otavioaugusto-dev/AquaRescue-ROV/PROJECT_ARCHITECTURE.md

# AquaRescue ROV
## Project Architecture Specification

---

**Project Name:** "Embarcação Robótica de Reconhecimento e Localização de Vítimas de Afogamento"

**Repository:**  
https://github.com/otavioaugusto-dev/AquaRescue-ROV

**Development Period:**  
2023 – 2025

**Institution:**  
Robotics Club – Colégio Militar do Corpo de Bombeiros do Ceará (CMCB)

**Primary Contributor:**  
Otávio Augusto

**Document Version:**  
v1.0

**Document Status:**  
In Development

---

# Table of Contents

1. Project Overview
2. Problem Statement
3. Project Objectives
4. Stakeholders
5. Engineering Requirements
6. System Overview 
7. Mechanical Architecture 
8. Electrical Architecture 
9. Embedded System 
10. Computer Vision System 
11. Communication Architecture 
12. Power Distribution 
13. Operating Modes 
14. Validation and Field Testing 
15. Engineering Trade-offs
16. Project Limitations
17. Awards and Recognition
18. Lessons Learned
19. Future Improvements
Appendix A — Acronyms
Appendix B — Revision History

---

# 1. Project Overview

## Abstract

AquaRescue is a low-cost robotic surface vehicle developed to assist search and rescue operations involving drowning victims. The project combines embedded systems, computer vision, wireless communication, naval engineering concepts, and artificial intelligence to provide firefighters with a technological support platform capable of improving operational safety and increasing search efficiency.

The platform was conceived through a user-centered engineering approach, beginning with interviews conducted with military firefighters, rescue divers, and professionals experienced in aquatic rescue operations. Their operational requirements guided the project's conception and technical decisions throughout its development.

Unlike conventional remotely operated platforms focused exclusively on teleoperation, AquaRescue integrates autonomous assistance features through computer vision techniques capable of identifying people in real time from underwater video streams. The system also incorporates modular mechanical construction, reusable materials, wireless communication, embedded propulsion control, and a portable operator station.

Throughout its development, AquaRescue evolved from an initial concept into a validated research prototype tested in controlled aquatic environments and presented at national scientific competitions. The project demonstrates how affordable engineering solutions can contribute to public safety while simultaneously serving as an educational platform for multidisciplinary engineering research.

---

# 2. Problem Statement

According to the World Health Organization (WHO), drowning causes more than 236,000 deaths every year worldwide, remaining one of the leading causes of accidental mortality.

Search operations performed by rescue teams are frequently characterized by long operational periods, limited underwater visibility, significant physical effort, and considerable risks to rescue divers. These factors increase operational costs while exposing professionals to hazardous environments.

During the project's conception phase, the development team interviewed firefighters, rescue divers, and military personnel from the Ceará Military Fire Department (CBMCE). These interviews revealed recurring operational challenges related to underwater victim localization, including:

- Limited underwater visibility;
- High physical fatigue during prolonged searches;
- Exposure of rescue divers to hazardous environments;
- Emotional pressure experienced by rescue teams;
- Psychological distress for victims' families during long search operations.

The motivation for the project became even stronger following a real drowning incident at the Federal University of Ceará (UFC), where search operations lasted several days due to the complexity of the underwater environment.

Based on these observations, the Robotics Club proposed the development of a robotic platform capable of supporting firefighters during search operations while reducing human exposure to hazardous situations through the use of embedded technologies and computer vision.

---

# 3. Project Objectives

## General Objective

Develop a low-cost robotic platform capable of assisting search and rescue teams during drowning victim localization by combining embedded systems, wireless communication, computer vision, and modular mechanical design.

## Specific Objectives

- Develop a stable catamaran-based floating platform;
- Design a modular waterproof structure suitable for aquatic environments;
- Implement a dual-motor propulsion system;
- Provide real-time underwater video streaming;
- Integrate computer vision techniques for human detection;
- Develop both manual and autonomous operating modes;
- Minimize operational costs through the reuse of mechanical components whenever feasible;
- Validate the platform under realistic field conditions;
- Demonstrate the feasibility of affordable robotic technologies for public safety applications.

---

# 4. Stakeholders

## Primary Stakeholders

- Ceará Military Fire Department (CBMCE)
- Search and Rescue Teams
- Firefighters
- Rescue Divers
- Victims and Their Families

## Secondary Stakeholders

- Robotics Club (CMCB)
- Engineering Students
- Educational Institutions
- Scientific Community
- Science Fair Organizations

---

# 5. Engineering Requirements

## Functional Requirements

| ID | Requirement | Status |
|:---|:---|:---:|
| FR-01 | Navigate over water using differential propulsion | ✔ |
| FR-02 | Support manual remote operation | ✔ |
| FR-03 | Support autonomous navigation | Prototype |
| FR-04 | Capture underwater video | ✔ |
| FR-05 | Stream live video to the operator station | ✔ |
| FR-06 | Detect people using computer vision | ✔ |
| FR-07 | Illuminate underwater environments | ✔ |
| FR-08 | Raise and lower the underwater camera | ✔ |
| FR-09 | Provide visual status indication | ✔ |

## Non-Functional Requirements

| ID | Requirement |
|:---|:---|
| NFR-01 | Low-cost construction |
| NFR-02 | Modular architecture |
| NFR-03 | High buoyancy |
| NFR-04 | Easy maintenance |
| NFR-05 | Waterproof electronics enclosure |
| NFR-06 | Reuse of recycled materials whenever possible |
| NFR-07 | Portable operation by a single operator |
| NFR-08 | Stable communication during field operation |

------

# 6. System Overview

## System Description

AquaRescue is composed of multiple engineering subsystems working together to support aquatic search and rescue missions.

Instead of being designed as a single robotic platform, the project follows a modular architecture where each subsystem performs a specific function while communicating with the remaining modules.

This modular approach simplifies maintenance, future upgrades, fault isolation, and hardware replacement while allowing each subsystem to evolve independently.

The complete system is divided into the following major subsystems:

- Mechanical Structure
- Propulsion System
- Embedded Control System
- Underwater Imaging System
- Computer Vision System
- Communication System
- Power Distribution System
- Human-Machine Interface

---

## High-Level System Architecture

> See **Diagram D-04 — Communication Architecture** in `diagrams/README.md`.

---

# 7. Mechanical Architecture

## Mechanical Design Philosophy

The mechanical structure was designed following three primary engineering principles:

- High buoyancy;
- Mechanical simplicity;
- Low manufacturing cost.

To achieve these objectives, the development team adopted a catamaran configuration composed of two PVC floating hulls connected by an anodized aluminum frame.

This configuration provides excellent lateral stability while creating sufficient internal space for propulsion components and electronic systems.

---

## Floating Structure

The floating platform consists of:

- Two 100 mm PVC pipes acting as flotation pontoons;
- An anodized aluminum structural frame;
- A sealed acrylic enclosure positioned between the pontoons;
- Reinforced mechanical supports for propulsion motors;
- Centralized weight distribution.

PVC was selected due to its:

- Low cost;
- High corrosion resistance;
- Excellent buoyancy;
- Ease of machining;
- Wide commercial availability.

Most structural components were obtained from recycled construction materials, reducing manufacturing costs while promoting sustainable engineering practices.

---

## Waterproof Enclosure

A central 11-liter acrylic enclosure houses the embedded electronics.

The enclosure protects:

- Arduino controller;
- Relay modules;
- Battery pack;
- Voltage regulators;
- Internal wiring;
- Camera winch mechanism.

Waterproof sealing was achieved using PU40 polyurethane sealant, providing protection against water ingress during field operation.

---

## Camera Deployment Mechanism

Instead of fixing the underwater camera directly below the platform, the project employs a motorized winch mechanism.

The system consists of:

- Automotive window motor (12 V);
- Cable spool;
- Camera support cable;
- Relay-controlled actuation.

This mechanism allows the operator to adjust camera depth according to water conditions, improving visibility while reducing image disturbances caused by surface turbulence.

---

## Mechanical Advantages

The selected mechanical architecture provides several operational benefits:

- High stability;
- Low center of gravity;
- Easy transportation;
- Modular maintenance;
- Simple assembly;
- Low production cost;
- Scalability for future upgrades.

---

# 8. Propulsion System

## Differential Drive Configuration

The propulsion system adopts a differential drive configuration composed of two independent DC motors positioned near the rear section of each floating pontoon.

This configuration allows movement without requiring rudders or steering mechanisms.

Vehicle motion is obtained by varying the rotational direction and speed of each propulsion motor.

Examples include:

| Left Motor | Right Motor | Movement |
|---|---|---|
| Forward | Forward | Forward |
| Reverse | Reverse | Backward |
| Forward | Reverse | Rotate Right |
| Reverse | Forward | Rotate Left |
| Stop | Forward | Smooth Left Turn |
| Forward | Stop | Smooth Right Turn |

---

## Propulsion Motors

The propulsion system employs:

- Two 12 V DC motors;
- High torque;
- High rotational speed;
- Gear-assisted mechanical transmission.

Mechanical components were recovered from discarded printers, reducing manufacturing costs while maintaining acceptable mechanical reliability.

---

## Propeller Design

Rather than using commercial marine propellers, the project reused four-blade propellers recovered from microwave oven cooling systems.

Engineering considerations included:

- Increased thrust at low RPM;
- Higher propulsion efficiency;
- Reduced battery consumption;
- Lower mechanical stress on transmission components.

Additional gears and bearings were incorporated to reduce shaft loading and improve long-term durability.

---

## Mechanical Transmission

The propulsion assembly includes:

- Bearings;
- Gear reduction;
- Motor couplings;
- Reinforced supports.

This mechanical arrangement minimizes vibration while improving energy transfer from the motors to the propellers.

---

## Design Considerations

The propulsion subsystem was designed to satisfy the following engineering constraints:

- Low manufacturing cost;
- Easy maintenance;
- Component availability;
- Mechanical robustness;
- Operational reliability;
- Efficient battery utilization.

---

# 9. Embedded Control System

## Design Philosophy

The embedded control system was designed following a distributed architecture in which each processing unit is responsible for a well-defined subset of tasks.

Instead of concentrating every function into a single microcontroller, the project separates navigation control from image acquisition and processing.

This approach reduces computational load, simplifies software maintenance, and improves overall system reliability.

The embedded architecture is divided into three processing layers:

- Low-Level Control
- Image Acquisition
- High-Level Computer Vision

---

## Low-Level Controller

The low-level controller is responsible for all real-time interactions with the robotic platform.

An Arduino Uno was selected due to its robustness, simplicity, large community support, and sufficient computational capability for deterministic control tasks.

Its responsibilities include:

- Reading Bluetooth commands;
- Controlling propulsion motors;
- Operating relay modules;
- Controlling the camera winch;
- Managing underwater lighting;
- Driving visual indicators;
- Executing navigation logic.

The Arduino operates independently from the computer vision subsystem, ensuring that vehicle control remains operational even if video processing is interrupted.

---

## Relay-Based Actuation

Instead of employing dedicated H-bridge motor drivers, the propulsion system utilizes relay modules to reverse motor polarity.

Although unconventional for robotic applications, this solution presented several advantages during development:

- Low implementation cost;
- Easy maintenance;
- Electrical isolation;
- Simple replacement;
- Availability of components.

Each relay module is controlled directly by the Arduino digital outputs.

---

## Embedded Responsibilities

The embedded system is responsible for:

| Function | Responsible Module |
|---|---|
| Propulsion control | Arduino Uno |
| Camera elevation | Arduino Uno |
| Lighting control | Arduino Uno |
| Visual indicators | Arduino Uno |
| Bluetooth communication | HC-05 Bluetooth Module |
| Motor switching | Relay Modules |

---

## Design Considerations

The embedded system prioritizes deterministic behavior over computational complexity.

Image processing tasks are intentionally delegated to an external computer, allowing the Arduino to maintain stable timing for vehicle control.

This architectural decision significantly reduces software complexity while improving reliability during field operations.

---

# 10. Computer Vision System

## Overview

One of AquaRescue's most innovative characteristics is the integration of computer vision techniques to assist firefighters during victim localization.

Instead of requiring operators to continuously inspect video streams manually, the system automatically analyzes incoming frames and highlights potential human detections in real time.

The objective is not to replace human judgment, but to reduce operator fatigue during prolonged search missions.

---

## System Architecture

The computer vision subsystem is composed of three independent stages:

1. Image Acquisition
2. Image Processing
3. Human Detection

Each stage operates independently while exchanging information through network communication.

---

## Image Acquisition

An ESP32-CAM module is responsible for transmitting live underwater video.

The ESP32 does not execute artificial intelligence algorithms.

Its exclusive responsibility is image acquisition and video streaming.

The module operates as a lightweight MJPEG streaming server connected through a local Wi-Fi network.

Typical streaming pipeline:

See **Diagram D-01 — High-Level System Architecture** in `diagrams/README.md`.
---

## Processing Layer

The operator's notebook executes all computer vision algorithms.

Python was selected due to its mature ecosystem for artificial intelligence and image processing.

Major software components include:

- Python
- OpenCV
- NumPy
- cv2.dnn module

This architecture allows computationally intensive algorithms to execute on hardware considerably more powerful than a microcontroller.

---

## Human Detection

Each received frame undergoes the following processing pipeline:

Frame Acquisition

↓

Image Decoding

↓

Pre-processing

↓

Neural Network Inference

↓

Bounding Box Generation

↓

Confidence Evaluation

↓

Visual Alert

↓

Display

The implemented detection algorithm identifies human figures and overlays bounding boxes on detected individuals while presenting confidence information to the operator.

---

## Design Philosophy

Rather than embedding artificial intelligence directly into the robotic platform, the project deliberately separates sensing from inference.

This decision provides several engineering advantages:

- Lower onboard power consumption;
- Simpler embedded software;
- Reduced hardware cost;
- Easier model replacement;
- Increased computational performance;
- Future compatibility with more advanced neural networks.

---

# 11. Communication Architecture

## Overview

AquaRescue employs two independent communication channels, each optimized for a specific operational purpose.

This separation increases system robustness while simplifying subsystem integration.

---

## Bluetooth Communication

Bluetooth is responsible for command transmission between the operator and the robotic platform.

Commands include:

- Forward movement;
- Reverse movement;
- Turning;
- Camera elevation;
- Lighting control;
- Navigation mode selection.

The Bluetooth link connects directly to the Arduino controller.

---

## Wi-Fi Communication

Video transmission occurs independently through a dedicated Wi-Fi connection.

The ESP32-CAM operates as an MJPEG streaming server, continuously transmitting underwater video to the operator notebook.

The notebook accesses the stream through a standard HTTP endpoint and processes each received frame using OpenCV.

This architecture isolates navigation control from video transmission, preventing failures in one subsystem from directly affecting the other.

---

## Communication Summary

| Communication | Purpose |
|---|---|
| Bluetooth | Robot control |
| Wi-Fi | Video transmission |
| HTTP MJPEG | Image streaming |
| USB | Software upload and maintenance |

---

## Engineering Rationale

Separating control communication from video transmission increases fault tolerance.

Even if the video stream experiences temporary degradation, the operator maintains full control over vehicle navigation through the independent Bluetooth channel.

This modular communication architecture improves operational safety during rescue missions.

---

# 12. Power Distribution System

## Overview

Reliable power distribution is essential for autonomous robotic platforms operating in remote environments. Since the AquaRescue platform performs propulsion, illumination, wireless communication, image acquisition, and embedded control simultaneously, the electrical system was designed to isolate high-current loads from sensitive electronic devices.

The platform uses two interchangeable battery packs, allowing continuous operation while one pack is being recharged.

---

## Battery System

The primary energy source consists of lithium-ion 18650 rechargeable cells assembled into custom battery packs.

### Battery Specifications

| Parameter | Value |
|---|---|
| Battery Chemistry | Li-Ion 18650 |
| Configuration | 3S10P |
| Cells per Pack | 30 |
| Number of Packs | 2 |
| Nominal Voltage | 11.1 V |
| Maximum Voltage | 12.6 V |

Using two independent battery packs allows uninterrupted field operation by replacing the depleted pack while charging the spare unit.

---

## Power Distribution

The battery pack supplies power to different subsystems according to their electrical requirements.

See **Diagram D-03 — Electrical Architecture** in `diagrams/README.md`.

---

## Voltage Regulation

Because the robotic platform integrates electronic modules operating at different voltage levels, dedicated voltage regulators are used to supply low-voltage electronics while isolating them from motor-induced voltage fluctuations.

The regulated supply powers:

- Arduino Uno
- ESP32-CAM
- Bluetooth Module
- Logic circuits

This architecture improves electrical stability and reduces the risk of unexpected microcontroller resets caused by propulsion motor startup currents.

---

## Engineering Considerations

The power distribution architecture prioritizes simplicity, maintainability, and field reliability over electrical complexity.

Separating propulsion loads from embedded electronics reduces electrical noise and contributes to more stable system behavior during navigation.

---

# 13. Operating Modes

## Manual Mode

Manual mode was designed to maximize operator control during search missions.

The firefighter operates the platform remotely using a Bluetooth controller while simultaneously monitoring the underwater video feed displayed on a notebook.

Available commands include:

- Forward movement
- Reverse movement
- Left turn
- Right turn
- Camera elevation
- Underwater lighting
- Navigation mode selection

Manual operation is particularly useful during detailed inspection of specific underwater regions identified by the rescue team.

---

## Autonomous Mode

The project also proposes an autonomous navigation mode intended to assist large-area search operations.

Instead of relying exclusively on operator commands, the robotic platform follows predefined navigation constraints established by infrared reference beacons positioned around the search area.

When the onboard infrared sensors detect a boundary beacon, the Arduino automatically modifies the navigation trajectory, preventing the vehicle from leaving the designated operational region.

Although still considered a prototype feature, preliminary experiments demonstrated the feasibility of implementing virtual operational boundaries without requiring GPS.

---

## Operational Workflow

See **Diagram D-07 — Mission Workflow** in `diagrams/README.md`.
---

# 14. Validation and Field Testing

## Testing Philosophy

The AquaRescue platform was validated through iterative engineering cycles composed of design, implementation, testing, and refinement.

Each testing session provided practical feedback that guided improvements in both hardware and software.

---

## Controlled Environment

Initial experiments were conducted in the Olympic swimming pool of Colégio Militar do Corpo de Bombeiros do Ceará.

The controlled environment allowed safe evaluation of:

- Vehicle stability
- Propulsion efficiency
- Waterproofing
- Camera deployment
- Wireless communication
- Human detection

---

## Open Water Validation

After laboratory validation, the robotic platform was tested in natural aquatic environments at Tabuba Beach, Ceará.

The selected location includes river and ocean interaction, providing more realistic operating conditions.

Field tests demonstrated:

- Stable floating behavior
- Reliable propulsion
- Good underwater visibility
- Successful live video transmission
- Positive person detection during underwater experiments

These tests confirmed the feasibility of the proposed architecture under realistic environmental conditions.

---

## Engineering Validation

The project successfully demonstrated:

✔ Mechanical stability

✔ Waterproof electronics enclosure

✔ Embedded propulsion control

✔ Live wireless video transmission

✔ Computer vision integration

✔ Modular architecture

✔ Field operation capability

Although conceived as a research prototype, the project proved that affordable embedded technologies can effectively support public safety applications.

---

# 15. Engineering Trade-offs

Engineering projects frequently require balancing performance, cost, complexity, and reliability. Throughout AquaRescue's development, several technical decisions were intentionally made after evaluating these trade-offs.

| Decision | Benefit | Limitation |
|---|---|---|
| Catamaran hull | Excellent stability | Larger overall footprint |
| Relay-based motor control | Low cost and easy replacement | Lower efficiency than H-bridge drivers |
| External computer vision processing | Higher computational capability | Requires operator notebook |
| ESP32-CAM streaming | Low-cost wireless imaging | Dependent on Wi-Fi quality |
| Recycled mechanical components | Significant cost reduction | Greater effort during mechanical adaptation |
| Differential propulsion | Simple steering without rudders | Less efficient turning at very low speeds |

Documenting these engineering decisions is important because they reflect the project's design philosophy: prioritize affordability, maintainability, and practical deployment over maximum technological sophistication.

---

# 16. Project Limitations

## Overview

As a research and educational prototype, AquaRescue was designed to demonstrate the feasibility of applying embedded systems, computer vision, and low-cost robotics to aquatic search and rescue operations.

Although the platform achieved its primary objectives, several technical limitations were identified throughout development.

Understanding these limitations is essential for guiding future improvements and evaluating the project's current operational scope.

---

## Current Limitations

| Area | Current Limitation |
|---|---|
| Computer Vision | Detection performance depends on water visibility and lighting conditions. |
| Positioning | The platform does not incorporate GPS or underwater localization systems. |
| Communication | Video transmission quality depends on Wi-Fi signal availability. |
| Processing | Artificial intelligence algorithms execute on an external notebook rather than onboard hardware. |
| Navigation | Autonomous navigation is limited to infrared boundary detection. |
| Waterproofing | Designed for shallow-water operation and controlled environments. |

---

## Engineering Perspective

The identified limitations reflect conscious engineering decisions made to prioritize affordability, modularity, and rapid prototyping.

Rather than maximizing technological complexity, the project focused on demonstrating a functional and accessible solution capable of supporting rescue professionals while remaining feasible within educational and financial constraints.

---

# 17. Awards and Recognition

## Scientific Exhibitions

Throughout its development, AquaRescue was presented at several scientific and technological events, where it received recognition for its engineering innovation and social impact.

### Ceará Faz Ciência 2023

The project was selected for presentation during Ceará Faz Ciência, one of the state's largest science and technology exhibitions.

This event provided an opportunity to demonstrate the platform to researchers, students, educators, and public institutions.

---

### Mostra Nacional de Robótica (MNR) 2023

AquaRescue was presented at the Brazilian National Robotics Exhibition (MNR), held in Salvador, Bahia.

The project received positive evaluations regarding its multidisciplinary integration of embedded systems, robotics, artificial intelligence, and public safety applications.

---

### FEBRACE 2024

The project represented Colégio Militar do Corpo de Bombeiros do Ceará at the Brazilian Science and Engineering Fair (FEBRACE), hosted by the University of São Paulo (USP).

Among hundreds of projects from across Brazil, AquaRescue achieved:

**4th Place Overall — Engineering Category**

This recognition validated both the technical quality of the project and its potential social contribution.

---

## Practical Validation

Beyond scientific exhibitions, AquaRescue was evaluated during practical demonstrations involving firefighters from:

- Colégio Militar do Corpo de Bombeiros do Ceará (CMCB)
- Corpo de Bombeiros Militar do Ceará (CBMCE)
- Search and Rescue Battalion (BBS)

Field demonstrations confirmed the feasibility of applying low-cost embedded technologies to aquatic search operations.

---

# 18. Lessons Learned

The development of AquaRescue provided valuable engineering experience extending beyond robotics itself.

Major lessons learned include:

- Complex engineering problems require multidisciplinary thinking.
- Mechanical design directly influences electronic reliability.
- Early prototyping accelerates technical validation.
- Field testing reveals issues not observable in laboratory environments.
- Modular architectures simplify maintenance and future upgrades.
- Documentation is as important as implementation for long-term project sustainability.

The project also reinforced the importance of collaboration between engineering and public safety professionals during the development of technological solutions for real-world applications.

---

# 19. Future Improvements

Although AquaRescue successfully demonstrated the proposed concept, several improvements have been identified for future versions.

Potential developments include:

- Integration of autonomous navigation using GPS and waypoint planning.
- Deployment of onboard artificial intelligence accelerators.
- Real-time telemetry dashboard.
- Improved underwater communication systems.
- Sonar integration for low-visibility environments.
- Object tracking algorithms.
- Battery management system (BMS) with real-time monitoring.
- Waterproof industrial enclosure.
- Brushless propulsion motors.
- Mobile application for remote mission monitoring.

These improvements aim to increase operational capability while preserving the project's original philosophy of affordability and modularity.

---

# Appendix A — Acronyms

| Acronym | Description |
|---|---|
| AI | Artificial Intelligence |
| BBS | Search and Rescue Battalion |
| CBMCE | Corpo de Bombeiros Militar do Ceará |
| CPS | Cyber-Physical System |
| ESP32 | Espressif ESP32 Microcontroller |
| HMI | Human-Machine Interface |
| HTTP | Hypertext Transfer Protocol |
| IoT | Internet of Things |
| MJPEG | Motion JPEG |
| OpenCV | Open Source Computer Vision Library |
| ROV | Remotely Operated Vehicle |
| Wi-Fi | Wireless Local Area Network |

---

# Appendix B — Revision History

| Version | Description |
|---|---|
| v0.1 | Initial repository structure |
| v0.2 | Mechanical and system architecture |
| v0.3 | Embedded systems and communication architecture |
| v0.4 | Power distribution, validation and engineering trade-offs |
| v1.0 | Final technical documentation with diagrams and appendices |

## Revision History

| Version | Date | Description |
|:---|:----|:---|
| v0.1 | 2026 | Initial architecture specification containing project definition, objectives, stakeholders, and engineering requirements. |
| v0.2 | 2026 | Add architecture specification containing System Overview, Mechanical Architecture, and Propulsion System. |
| v0.3 | 2026 | Add embedded and comunication specification and fix schedule. |
| v0.4 | 2026 | Add engineering decisions and power system. |
| v1.0 | 2026 | Finalize documentation. |
