otavioaugusto-dev/AquaRescue-ROV/images/competitions/febrace_2024.jpg

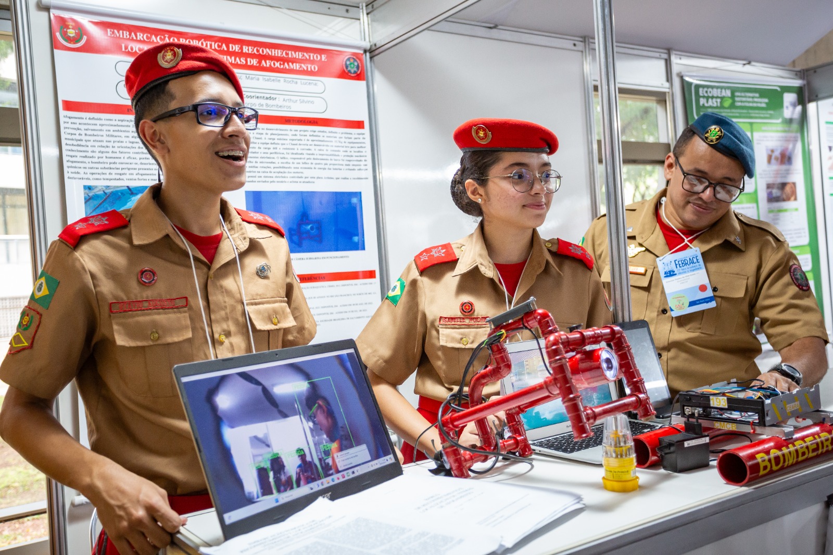
images/competitions/febrace_2024.jpg
