otavioaugusto-dev/AquaRescue-ROV/images/team/febrace_team.jpg

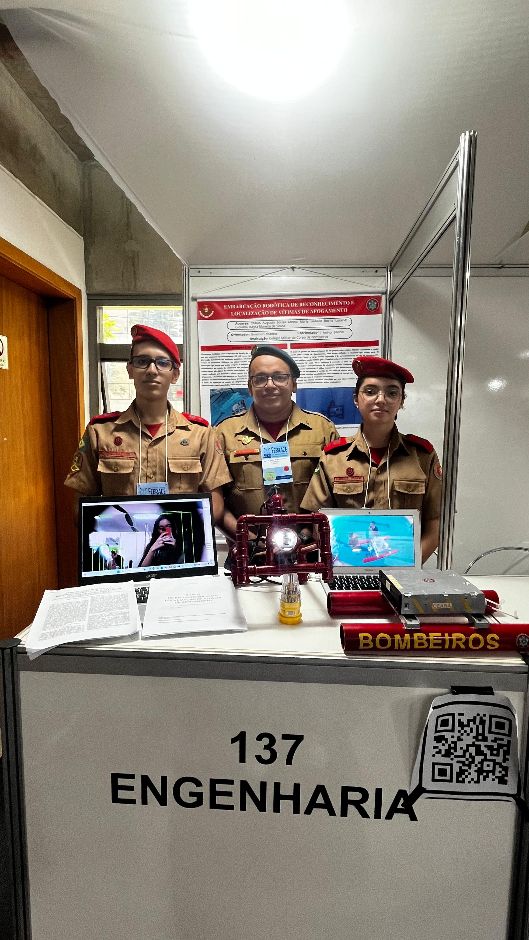
images/team/febrace_team.jpg
