otavioaugusto-dev/AquaRescue-ROV/(commit log)

2026-06-26 Create prototype folder
2026-06-28 docs: document power system, validation and engineering decisions (version 0.4)
2026-06-30 images: add prototype images
2026-08-12 feat(firmware): reconstruct Arduino control firmware
