otavioaugusto-dev/AquaRescue-ROV/(notices)

Notices in the files:
README.md:
MIT License
